evankdevilla-create/G-load-haptic-feedback-trainer/docs/CONTEXT.md

# hackPHS 2026: project context

Single source of truth for everyone on the team and their Claude agents. Last updated 2026-10-10 (day of event). If something here is stale, fix it here.

## What we're building
A cheap haptic G-load feedback trainer for flight sims. A pressure cuff on the thigh inflates in proportion to live G-load from the sim (FlightGear, via its built-in web server), the same squeeze cue real G-suit bladders give pilots.

- Event: hackPHS 2026, theme "Into the Skies". Tracks: ElevenLabs (voice), Cybersecurity, Codeset.
- Honest framing, required in the pitch: this is a G-load haptic feedback trainer, NOT a G-force simulator. Real G needs real acceleration and cannot be done cheaply. Saying this up front survives technical questions; an oversold claim does not.
- Pitch hook: commercial motion rigs cost $5k to $50k+, this is under $150. Same squeeze principle as a real G-suit bladder. (Don't claim Air Force trainers use this without a source.) No "future CS teacher" backstory, it doesn't connect.
- Honest read on judging: a real top-3 contender because a physical hardware demo stands out. The risk is live-demo flakiness, not the idea.

## Team and ownership
Four people, one Claude agent each. Handoff files are in `docs/handoffs/` in the repo: https://github.com/evankdevilla-create/G-load-haptic-feedback-trainer

| # | Role | File |
|---|---|---|
| 01 | Hardware / pneumatics (cuff, pump, solenoid, plumbing, timings) | `01-hardware-pneumatics.md` |
| 02 | Arduino firmware + relay wiring | `02-arduino-firmware.md` |
| 03 | Sim telemetry to serial bridge (Python), with demo mode | `03-telemetry-software.md` |
| 04 | Integration, demo, Devpost, pitch | `04-integration-demo-pitch.md` |

Names: kept out of this file because the repo is public. See the team chat.

## Build order
Hardware alone first (bench test), then telemetry software, then integration. Integration always takes longer than planned, so do an end-to-end run with `--demo` early and don't leave it to the last hours.

## Architecture
```
sim (FlightGear) -> Python bridge (laptop) -> USB serial -> Arduino Uno
   -> 2-ch relay -> 12V pump + vent solenoid -> thigh cuff
```
Power: 8xAA pack (12V) feeds the pump and solenoid through the relay COM terminals. The Arduino runs from USB. Never power loads through the Arduino.

## Serial contract (do not change without telling 02 and 03)
- 115200 baud, newline-terminated ASCII lines.
- Laptop to Arduino: `G:<float>\n`, about 20 Hz, clamped 0.0 to 9.0.
- Arduino may reply `OK\n`. Malformed lines are ignored.
- No valid line for 500 ms: Arduino vents fully and stops the pump.
- Optional `TEST\n` command: inflate 2 s, vent 2 s, for hardware checks.

## Findings so far (hardware, 2026-10-10)
- Pump: INFLATES on the 8xAA pack, confirmed with the other end sealed. Do not dead-head it for long, a stalled pump overheats.
- Solenoid: NORMALLY CLOSED (corrected 2026-10-11; listing and bench test agree, the earlier "normally open" note was wrong and it leaked when energized). It is wired to the relay's NC contact, so at the relay level nothing changes: relay on = closed/holds, relay off = valve powered = open = vents. Fail-safe now needs the valve pack B connected and charged. Holding pressure now draws NO coil current (valve unpowered while holding).
- T fitting: NOT needed. The cuff has two tubes, so pump (via check valve) goes on tube A and the vent solenoid on tube B, open to air on its other port. Still to verify: both tubes open into the same bladder (blow into A with B open, air should come out of B). The pump tubing is 3 mm OUTER diameter and the cuff tubes are bigger, so connectors are needed. Spare option if B turns out to be a dead end: printable socket T for 3 mm OD tubing in `hardware/t-fitting/`.
- Inflate time, free air: about 30 to 38 s from empty to fully inflated with the cuff NOT on a leg and the other tube sealed.
- Timings ON THE LEG (2026-10-10, hand-timed, approximate): **inflate to firm-but-comfortable about 30 s** (current pump, through the cuff's own thick tube, so tubing is not the limit, the pump is). About 10 s more and it starts to feel uncomfortable, so the max safe run is about 40 s and 35 s is a sensible `pumpMaxRunMs`. **Vent about 5 s max** with tube B open to air; through the solenoid port it will be slower, re-time once the valve adapter is printed. Far off the placeholders in `trainer_logic.h` (8 s / 4 s / 10 s). 02: suggested `inflateMs` 30000, `ventMs` 5000 (now 3000, see below), `pumpMaxRunMs` 35000.
- `ventMs` was retuned 2026-10-11 (1200 -> 3000) and is now live-tunable with the `VENTMS:<n>` serial command (`bridge/tune_vent.py`); the real vent is non-linear, so 3000 is a starting point.
- Pump holds pressure by itself with tube B pinched and the pump off, so no check valve needed. Solenoid coil heat test passed (but on the old wiring; the valve is normally CLOSED and now idles unpowered while holding), everything is wired, strap is good.
- 30 s is far too slow to follow a G pull in the sim. Fixes in order: (1) preload so 1 G is a light squeeze, (2) stronger pump (teammates buying, this is the main fix since tubing is already the thick cuff tube), (3) parked idea, NOT planned: an air reservoir with a normally closed dump valve. Only revisit if preload plus the new pump fall short.
- Valve adapter: the valve port is a 1/4" pipe thread (NPT or G1/4, not yet confirmed), being printed to connect tube B to the valve.

## Status (2026-10-10)
Each agent updates only its own line. See `CLAUDE.md` for the rules.

- **01 Hardware:** wired, strapped, pump holds pressure, valve is normally CLOSED (see Findings, corrected 2026-10-11), wired to the relay NC contact. On-leg timings measured (about 30 s inflate, about 5 s vent, about 40 s max, see Findings), so 02 can set them. No T needed (two-tube cuff). Using the cuff's own thick tube (not the 3 mm line). Valve adapter (cuff tube to the valve's 1/4" pipe-thread port) is being designed in CAD, not printed yet; until then the vent is tested with tube B open to air. Stronger pump from teammates not bought yet (specs in Open items). Fill is still too slow for a live pull (pump-limited). Not yet done: full loop through the solenoid, vent time through the solenoid, hardware tested with a real Uno.
- **03 Sim (new):** `sim/` is a first-person cockpit sim in React + TypeScript that flies a **set route at set G** (1 G up to 6 G, 98 s, loops) and drives the cuff. It exists because the FlightGear data download never finished, so there is no aircraft to fly - this needs nothing installed beyond `npm install`. It talks to the cuff by pretending to be FlightGear: `sim/server/g-server.mjs` answers on the same URL shape as `--httpd`, so `bridge.py --live` drives the Arduino from it **with no change to the bridge, the firmware or the serial contract**. Verified end to end against the real `bridge.py`. 22 physics tests pass, including a feasibility check that fails if the route asks for G the aeroplane cannot make. Run it with `cd sim && npm install && npm run dev`, then the bridge as usual. See `sim/README.md`.
- **03 Bridge:** `bridge/bridge.py` done. `--demo` (scripted flight, ENTER = 6 G spike, `--loop`), `--live` (FlightGear via `--httpd=5400`; X-Plane with `--sim xplane`), `--step` (square wave for timing cuff lag), `--print`, `--smoothing`, auto-detect + reconnect, CSV logs. **G property pick order fixed:** it now prefers `/accelerations/pilot-g` and refuses readings that aren't a believable load factor, which was the parked-c172p `Nz = 0.0` bug. One-command launcher `bridge/run-live.sh` starts FlightGear + the bridge together. Tested against `fake_flightgear.py` (4 scenarios) and `fake_xplane.py`; **still not tested with real FlightGear in flight or a real Arduino.**
- **02 Firmware:** `firmware/g_trainer/` written for the NO valve, with watchdog, dead-man, pump cap, deadband, re-zero, TEST/STOP/STATUS. Logic unit-tested on a laptop (20 checks pass). **Not yet uploaded to a real Uno. Timings are placeholders until 01 measures them.**
- **04 Integration:** **judging starts 10:00 AM Sunday Oct 11; live-sim cutoff 8:00 AM Sunday** (in the runbook). Runbook, pitch, Devpost and README now cover 03's `sim/` as the preferred live path (FlightGear second). Pitch numbers sourced: Qubic QS-210 motion set EUR 6,680 before tax, SimXperience G-Belt $999. Spare laptop (04's Mac): bridge set up; Node.js 24 installed; `sim/` tests pass and sim -> bridge `--live --print` verified end to end there (G followed the route). FlightGear installed as a backup, data download paused at ~430 MB. Stage note in the runbook: keep the sim window visible, a hidden tab sends 1 G and the squeeze drops out. Runbook has a timeline to judging; Devpost G-vs-time graph made (`pitch/g-vs-time-sim-route.png`, sim route, no cuff). Still to do: receipts total (none found yet, `[blank]` stays), first end-to-end run, backup video, two rehearsals.
- **Docs:** wiring in `docs/wiring.md`, demo steps + troubleshooting in `docs/demo-runbook.md`, pitch + Devpost drafts in `pitch/`.
- **Sim:** FlightGear (free, runs on Mac). Start it with `--httpd=5400` in the launcher's Additional Settings.

## Firmware logic (open loop, no pressure sensor)
- Map G to a target fill: 1 G or below = empty, about 6 G or more = full. Linear between.
- Track estimated fill by integrating pump and vent time using 01's measured timings. Deadband so relays don't chatter.
- With a NO solenoid: inflate = pump on + solenoid energized; hold = pump off + solenoid energized; vent = pump off + solenoid de-energized. Pump never runs while the solenoid is open.
- Hard cap on continuous pump run time, ~25% above the inflate time (shorter and the cuff never reaches full).
- Every return to 1 G vents all the way, which resets estimate drift.
- Watchdog timer resets a hung board; a reset leaves all relays off = vented.
- Relay boards are often active-low. Idle state of every pin must be "off" before setup() finishes.
- Pins: relay IN1 = solenoid/valve (pin 7), IN2 = pump (pin 8) (swapped 2026-10-11 for the two-pack rewire; was pump 7 / valve 8). The relay is a 2-CHANNEL board (not 4), so there are no spare channels. A second leg can't get its own valve: both cuffs would share the one pump and the one vent valve.

## Parts
Bought or planned: BP cuff + bladder (thigh), 12V mini air pump, solenoid valve, silicone tubing, T fittings, check valve, 8xAA holder, zip ties, velcro, small enclosure.
Already owned: 2x Arduino Uno (one is a cold spare), breadboard, jumpers, USB cables, 2-channel relay (5V logic, handles 12V loads), servo(s) of unknown torque, AA/AAA batteries.
Use AAs, not a 9V (9V sags under pump load).

## Scope
Core: one thigh cuff, one pump, one solenoid, Arduino over serial, plus a hardcoded demo mode in case the live sim flakes.
Stretch, only if the core runs on stage: second leg, directional bias via lateral G (4 solenoids), harness servo (needs about 10 to 13 kg-cm, MG996R class, not SG90), rib bladders. One working zone beats two half-wired zones.

## Safety
Firmware vents on serial loss, hard pump time cap, never exceed a firm but comfortable squeeze on a person. Mention this in the pitch.
- Wearer holds an inline kill switch on the 12V line. With the NO valve, cutting power stops the pump and vents the cuff at once.
- Flyback diodes (1N400x) across pump and valve if available. See `docs/wiring.md`.

## Software notes
- `pyserial` for the Arduino. FlightGear: the bridge reads JSON from `http://localhost:5400/json/<property>`, trying `/accelerations/pilot-g` first, then `/accelerations/pilot-gdamped`, then `/fdm/jsbsim/accelerations/Nz` as a last resort. **This order was reversed earlier today** - `Nz` used to be first and it read a valid `0.0` on the parked c172p, so the bridge locked onto a dead reading and the cuff would never have inflated. `pilot-g` is FlightGear core, so it works on JSBSim and YASim aircraft alike. The bridge now also refuses any reading that is not a believable load factor and prints why. Check in a browser that level flight reads ~1.0; override with `--fg-prop`. `sim/` serves the same two `pilot-g` properties, which is how it stands in for FlightGear.
- The Uno reboots when the serial port opens; the bridge waits 2 s after connecting.
- Light low-pass smoothing on G, but not so much that the cuff feels laggy.
- Log G to CSV for debugging and a pitch graph.

## Open items
- Task split per role: `docs/TASKS.md`.
- **Ownership of `sim/`:** new area, not in the `CLAUDE.md` table. It is sim telemetry, so 03 has been treating it as theirs alongside `bridge/`. Say so if you would rather it sat somewhere else.
- 03: the parked-c172p `Nz = 0` problem is **fixed** - the bridge was taking the first property that returned *any* number, and `0.0` counted. It now prefers `/accelerations/pilot-g` (FlightGear core, so it works on JSBSim and YASim aircraft alike) and rejects implausible readings out loud. Aircraft choice is handled too: `run-live.sh` defaults to the `f16`. What is still open is purely the human half: **fly a real pull and confirm G climbs** (`cd bridge && ./run-live.sh --print`).
- **No longer a blocker:** two things fixed this. 04 is fetching the FlightGear data directly (see the note below), and `sim/` gives us a cockpit sim that needs no download at all and drives the cuff through the same bridge. Whichever lands first, the live demo is covered.
- 03, from 04: the stalled fgdata download can be skipped. 04's Mac is fetching `FlightGear-2024.1.7-data.txz` (1.8 GB, md5 `ceedf4a112deebd4ead531082ffcd969`) straight from the SourceForge release-2024.1 folder, which resumes after drops unlike the launcher. Once it's unpacked, copy the folder to the demo laptop by USB or AirDrop. Also `run-live.sh` checks `Aircraft/$AIRCRAFT` by folder name, so `--aircraft F-86F` (folder `F-86`) prints a harmless "not installed" warning.
- **FlightGear, for reference:** FlightGear has no data on this laptop. The app is being run straight off the mounted `.dmg` (`/Volumes/FlightGear 2024.1.7/`), it was never installed to `/Applications`, and the `fgdata` download is **unfinished** - `~/Library/Application Support/FlightGear/_fgdata_downloading.temp` stalled at 673 MB and has not grown since 12:58. There are **zero aircraft installed**, so no live run of any kind is possible until this is sorted: drag FlightGear to `/Applications`, open it, and let the data download finish. Until then the stage demo rests entirely on `bridge.py --demo`, which does work.
- 03 and 02, from 04: the `sim/` route has the same fill problem as `DEMO_PROFILE`. Its turns hold G for 6 to 8 s ("6 G turn - full squeeze" is 6 s) with 1 G legs in between, and the firmware vents fully whenever the target is near empty, so each pull starts from empty and peaks around a quarter full with the ~30 s pump. For a felt squeeze: longer holds (about 20 to 30 s at the top G), shorter 1 G gaps, and 02's preload so 1 G holds a light baseline instead of venting.
- 02, from 03: the G-to-pressure curve (1 G = empty, ~6 G = full) lives in `firmware/g_trainer/trainer_logic.h`, which is yours. Once 01's real timings are in and the cuff is built, that curve is the knob for how hard the squeeze ramps. `bridge.py --step` gives you a clean 1 G -> 6 G -> 1 G square wave with the jump instant printed, so you can time the response on video instead of guessing.
- PROPOSED (01, not final): pre-compress the cuff(s) to a comfortable baseline as a setup step ("arm"), then G adds squeeze on top and stays capped below firm for safety. This shortens the pump-limited fill because only the top-up is slow. 02: preload level instead of empty at 1 G; the "vent fully on every return to 1 G" re-zero would drop to the preload level instead; add an arm step (vent, then inflate to the preload) and keep `pumpMaxRunMs` lower than the current 35 s (01 will set the number after testing comfort on the leg). 01 to test: how long the NO valve coil can stay energized holding the preload (needs a 10 to 15 min heat test, not 3 to 5), and a comfortable preload time. 04: pitch wording should say the squeeze is deliberately capped for safety and preloaded to a comfortable baseline, with no claim that it matches real G-suit pressures. A second cuff for the other leg is under discussion, not committed.
- PITCH GUIDANCE (01, for 04): do NOT say the weak pump was chosen on purpose from the start, that is not true (a stronger pump was looked for and could not be bought). A true framing: we decided to KEEP a small low-flow pump and reject high-power pumps (tire inflators, 150 psi, 10 A+) for safety, because a low-flow pump cannot slam pressure onto a leg if something fails. Speed is handled by preloading the cuffs to a comfortable baseline so a pull only adds a small top-up. State the trade-off plainly: the squeeze is slower than a real G onset (about 30 s to fully fill from empty); a stronger pump plus a pressure sensor is the next step. If a judge asks about the fill time, give the real number.
- FIRMWARE DRAFT (01 for 02 to review): branch `01-preload` implements the preload in `trainer_logic.h` and is now MERGED to main at 01's request (02 owns `firmware/`, please review and adapt): 1 G now means the preload baseline (`preloadMs` 25000 of `inflateMs` 30000), so at start it pumps ~25 s, holds, then follows G between the baseline and full. It also puts 01's measured timings in as the defaults (30000 / 5000 / 35000). 34 unit checks pass (14 new, written first). Caveats for 02: with a preload, returning to 1 G no longer vents to empty, so the fill estimate can drift over many pulls (re-zero with STOP + ~6 s); a pump-cap lockout now only clears after a full vent. Not flashed to a real Uno yet. 02: review, adapt if needed, and flash.
- PRELOAD NUMBER (01): about 25 s of pump time as the baseline (the on-leg time to fully firm is about 30 s, so that leaves only about 5 s of top-up and a small squeeze range on G). The pump cap must stay above the pump time needed for the highest squeeze 01 wants, about 25% over it; 01 does not want the squeeze limited below firm by the cap. 02: set the preload to 25 s as a starting value, tune on the leg.
- DECISION (01, 2026-10-10): a second/stronger pump can't be bought yet, so we proceed with the current pump (about 30 s fill on the leg, holds pressure). 02: add a preload so 1 G is a light squeeze. 03: stretch `DEMO_PROFILE` / slow the G onset so a slow fill still tracks the plane. Revisit a pump swap or a second pump in parallel only if time allows.
- WARNING on the pump candidate (01's view, not yet agreed): a 150 PSI 12V car tire inflator (the AstroAI one from Walmart) is the wrong kind of pump. It plugs into a car 12V socket and typically draws about 10 A or more (check the listing), which the 8xAA pack and a 10 A relay can't handle, and it can push far past a safe leg pressure (about 2 to 3 psi) in a second or two. It would need a real 12V source, a heavier relay, and a pressure relief or regulator on the cuff line. Prefer a small 12V pump under about 2 A, or a 12V air-mattress pump if it can reach 2 to 3 psi. Discuss before buying.
- Stronger pump (teammates buying, must be local, event is today): 12V DC positive-pressure air pump (not a vacuum pump), about 3 to 6 L/min (flow matters, not pressure; anything over about 300 mmHg is enough), under about 2 A running current (8xAA pack sags with more), outlet barb matching the cuff tubes plus spare connectors. No 12V tire inflators, too strong. Keep the kill switch and the pump cap, and 01 re-times max safe run time with the new pump.
- 03, from 04: `DEMO_PROFILE` holds each pull for about 3 s, but the cuff takes about 30 s to get firm on the leg, so the stage demo only gives a light squeeze. Please stretch the holds to roughly the measured inflate time (and re-time once the stronger pump is in). Same for the ENTER spike (`SPIKE_HOLD` is 2 s).
- Event day is today, so the pre-build policy email (team@hackphs.tech) is moot.
- Record a backup video of the cuff squeezing during a sim pull as early as possible.
- Total up real receipts for the "under $150" claim.
- 01: measure inflate time, vent time, max safe run time, then put them in `firmware/g_trainer/trainer_logic.h` and stretch `DEMO_PROFILE` in `bridge.py` if the cuff is slow.
- Hold pressure for 3 to 5 min on the bench and feel the valve coil; if it gets too hot, keep held squeezes short.
