evankdevilla-create/G-load-haptic-feedback-trainer/pitch/g-vs-time-sim-route.png

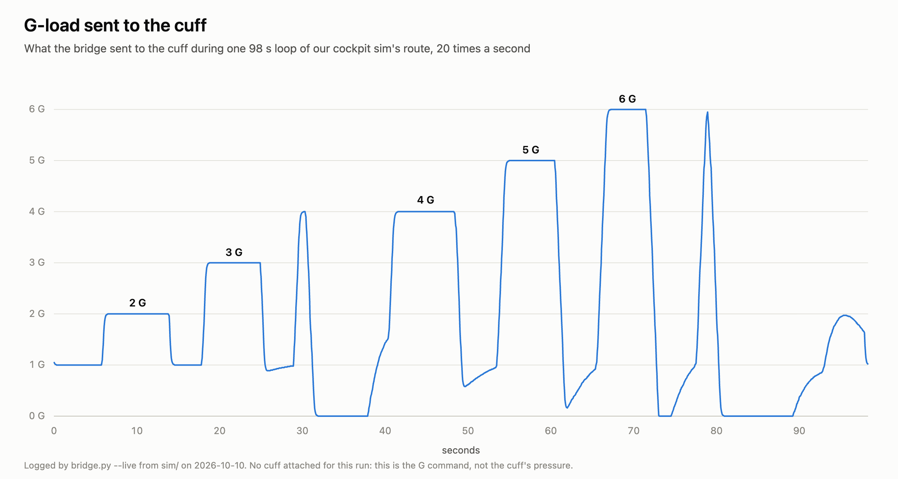
pitch/g-vs-time-sim-route.png
