evankdevilla-create/G-load-haptic-feedback-trainer/hardware/t-fitting/t-fitting.stl

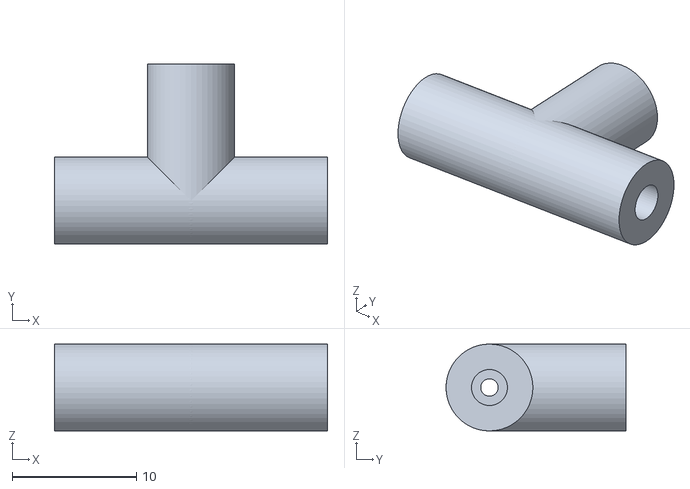
[picture p2: CAD file, 2026-10-10]
hardware/t-fitting/t-fitting.stl
22.0 x 14.5 x 7.00
