evankdevilla-create/G-load-haptic-feedback-trainer/(commit log)

2026-10-10 added fill time, tubing size and printable t fitting
    [t-fitting.scad, t-fitting.stl]
2026-10-10 removed t fitting since cuff has two tubes, added stronger pump specs
2026-10-10 03: fix G property pick, add one-command launcher and a cuff-lag test
    The parked-c172p bug is fixed. The bridge locked onto the first property
    that returned any number, and /fdm/jsbsim/accelerations/Nz returned a
    perfectly valid 0.0, so it picked a dead reading and the cuff would never
    have inflated on stage.
    - Prefer /accelerations/pilot-g. It lives in FlightGear's core, so it works
    whichever flight model the aircraft uses (the hangar F-16s come as both
    JSBSim and YASim), and it reads ~1.0 at rest. Nz is JSBSim-only and sits
    on a negative-Z axis, so it is last resort and gets its sign flipped.
    - Refuse any reading that is not a believable load factor, and print what
    every candidate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
    [bridge.py, fake_flightgear.py]
2026-10-10 added on-leg timings, 30 s inflate and 5 s vent
2026-10-10 fixed note, the pump limits fill time not the tubing
2026-10-10 added warning about using a 150 psi tire inflator as the pump
2026-10-10 04: sync runbook, pitch and Devpost with today's findings
    Runbook live mode now uses run-live.sh and pilot-g (03's fix), notes the
    FlightGear data blocker and a suggested cutoff. Pitch and Devpost use 01's
    measured timings, the two-tube cuff, real challenges from today, and
    sourced comparison prices. Asked 03 to stretch DEMO_PROFILE holds.
2026-10-10 04: drop the air reservoir from the pitch's speed answer (01 parked it)
2026-10-10 01: proceed with current pump, preload + slower demo ramp for now
2026-10-10 kept current pump, using preload and slower ramp for now
2026-10-10 04: follow 01's no-new-pump decision in runbook and Devpost
2026-10-10 04: judging 10 AM Sun, cutoff 8 AM; cover sim/ in runbook and pitch
    Set the live-sim cutoff from the judging time. Runbook, pitch, Devpost
    and README now treat 03's cockpit sim as the preferred live path, with
    FlightGear second. Flagged to 03/02 that the sim route's 6-8 s turns
    only reach about a quarter fill with the 30 s pump.
2026-10-10 04: spare laptop runs sim/ end to end; keep the sim window visible on stage
2026-10-10 03: fix stale property order in CONTEXT software notes
    The notes still listed Nz first, which is the order that caused the
    parked-c172p bug. Anyone debugging the live sim on stage would have
    followed it straight back into the problem. Also point out that sim/
    serves the same two pilot-g properties.
2026-10-10 01: proposed comfortable preload + capped squeeze; coil heat test needed
2026-10-10 added preload and capped squeeze idea, coil heat still needs testing
2026-10-10 01: pitch guidance, honest framing of the low-flow pump
2026-10-10 added pitch notes about the slow pump
2026-10-10 04: timeline to 10 AM judging; own-sim and pump questions in the pitch
    Runbook gets a Saturday-night / Sunday-morning checklist around the 8 AM
    cutoff. Pitch adds 'why your own sim' and reframes the fill-time answer
    per 01's guidance (kept a low-flow pump for safety, real numbers).
2026-10-10 01: relay is 2-channel (no leg-2 valve), preload about 25 s
2026-10-10 changed relay to 2 channel and preload to about 25 s
2026-10-10 04: G-vs-time graph for the Devpost, plus the script that makes it
    Graph is one loop of the sim route as logged by bridge.py --live (G
    command only, no cuff attached). make_g_graph.py turns any bridge log
    into the same chart for when a real cuff run exists.
2026-10-10 04: relay is 2-channel in the Devpost parts list (01's correction)
2026-10-10 01: wiring doc, daisy-chain two cuffs on one pump and one valve, no check valve
2026-10-10 added wiring doc for two cuffs on one pump and one valve
2026-10-10 01: tidy wiring diagrams
2026-10-10 cleaned up wiring diagrams
2026-10-11 01: preload mode, pump 25 s to a baseline then follow G (draft for 02 to review)
    Sets the real on-leg timings (30 s inflate, 5 s vent, 35 s cap, 25 s preload). Tests first.
2026-10-11 added preload mode so the pump fills to a baseline before following g
2026-10-11 03: strip sim hud to g + controls, 10 g pilot cap, 0.6x time scale
    Hud is now the G readout, cuff status/safety buttons and controls only.
    Removes cockpit canopy, map, G profile, instruments, honesty banner.
    PILOT_MAX_G and N_STRUCTURAL_MAX 10 (bridge/g-server still clamp to 9).
    Also includes the manual-flight, voice-callout and cuff-model work that
    was sitting uncommitted in sim/.
2026-10-11 cut sim hud down to g and controls, raised pilot cap to 10 g, slowed time to 0.6x
2026-10-11 01/02: valve rewired to its own pack on pin 7, pump on pin 8, ventMs 1200
    Valve is a normally-closed solenoid on its relay's NC contact, so relay off
    still vents. Pin swap and vent time measured on the rig; firmware tests pass.
    [g_trainer.ino, trainer_logic.h]
2026-10-11 moved valve to pin 7 and pump to pin 8, set vent time to 1200 ms
2026-10-11 02: firmware safety limits, output watchdog, tunable vent
    - 20 s full-hold limit: vents to the preload baseline until G drops below 2
    - OutputGuard latches a FAULT (pump off, valve relay off = vent) if the pump
    output runs past its cap or its rolling budget; CLEAR resets it
    - Rolling pump budget (60 s per 2 min); TEST is one-shot with a 10 s cooldown
    - ventMs 3000 default, live-tunable with VENTMS:<n> (500..10000)
    - G lines accept only numeric characters and finite values (no inf/nan -> 9 G)
    - 96 logic checks pass
    [g_trainer.ino, trainer_logic.h]
2026-10-11 03: bridge hardening, Linux port detection, tune_vent helper
    - Drop non-finite/out-of-range G before smoothing; clamp(NaN) is 0, not 9
    - LIVE_TIMEOUT_S 0.3 and clear last value on a failed poll, so a dead sim
    stops the stream within the firmware dead-man window
    - Detect the Uno on Linux (ttyACM*/ttyUSB*, Arduino vendor ids)
    - X-Plane socket binds localhost and ignores other senders
    - tune_vent.py: guided pull-and-release cycle for tuning VENTMS
    - run-live.sh creates logs/ first
    [bridge.py, test_ports.py, test_safety.py, tune_vent.py]
2026-10-11 03: sim chase view, F-35 jet, grid terrain, buttons-only cuff panel
    - Chase camera (C toggles), procedural F-35A-proportioned jet with a GLB
    loader for /models/f35.glb when present
    - Flat grid terrain, no hills/towns/clouds, no glow
    - Cockpit pitch ladder and horizon using the camera's real projection
    - Cuff panel reduced to Kill link / Panic vent / Voice buttons
    - Flight data strip, G meter zones and cuff-saturation tag
2026-10-11 added firmware safety limits and a pump watchdog so the cuff cant stay inflated
2026-10-11 added chase camera, f35 jet, grid ground and simpler cuff buttons
2026-10-11 03: ground collision, smooth render interpolation, rigid chase camera
    - Hitting the ground is a crash: the aircraft freezes, speed 0, G back to 1 so an
    impact never reaches the cuff; R restarts. The auto pull-up is removed.
    - Render interpolation between physics steps (lerpState), so frames land smoothly
    at any frame rate; the cuff and HUD numbers still read the real state
    - Chase camera attached rigidly to the jet (no trailing lag) and aimed slightly
    below it so the jet rides clear of the instruments
2026-10-11 03: fighter-style instrument cluster and per-frame horizon
    - Four flat ring gauges: G (-5..+10 with max/min hold, cuff-full mark at 6),
    airspeed with Mach, altimeter with digital window and VS, attitude ball
    - Gauge geometry, ISA Mach and VVI in pure, tested functions
    - Cockpit horizon driven per frame; CRASHED banner; controls reduced to buttons
    - Sources and which facts are verified are listed in src/hud/instruments/README.md
2026-10-11 added ground crashes, smoother frames and a locked chase camera
2026-10-11 03: roll holds its bank, no push-over G floor, clamp posted G
    - Roll is a rate command: the bank stays where the stick leaves it (no auto-level)
    - Removed the -1.5 G push-over floor and the -3 G structural floor (now -9)
    - gToPost clamps to 0..12 and drops non-finite values: negative G is baseline to
    the firmware, and the g-server rejects it, which would have gone stale and
    vented the cuff during a push-over
2026-10-11 03: hamburger menu, unboxed bottom-right instruments, matte grass ground
    - Menu (top left) holds pause/restart/cuff link, kill/panic/voice and the key list
    - Instrument cluster has no box and sits bottom right, with outlined labels
    - Ground is a matte cartoon-grass texture instead of a thin-line grid
    - Keyboard shortcuts (K, X, V, P, R, C, M) still work with the menu closed
2026-10-11 made roll keep its bank and clamped posted g to 0-12 so negative g cant vent the cuff
2026-10-11 moved controls into a menu and changed ground to grass so the screen is less cluttered
2026-10-11 04: rename the project G-Hug
    README title, Devpost name, pitch script and browser tab title. The honest
    descriptor stays: a G-load haptic feedback trainer, not a G-force simulator.
2026-10-11 03: afterburner, TABS-style ground, model slot, downward motion restored
    - Afterburner: one solid gradient cone that lengthens with throttle (tested curve)
    - Ground: white plane with a light-grey grid, after the TABS Simulation map
    - F-35 model slot: loads /models/f35.glb if present, hides gear-down meshes;
    credit shown in the menu from credit.txt; model files are gitignored because
    the only account-free copy is non-commercial / personal-use only
    - Push-over limits restored to -1.5 G (pilot) / -3 G (structural), pinned by a test
2026-10-11 renamed the project to g-hug in readme, devpost, pitch and tab title
2026-10-11 added afterburner flame and f35 model slot, made ground a grid, put push-over g limits back
